dlkj/pi-nano-choc-keyboard/README.md

# pi-nano-choc-keyboard
Split ergo keyboard based on the Rasberry Pi Nano and Kailh Choc v1 switches
