dlkj/pi-nano-choc-keyboard/pcb/pcb_edge.dxf

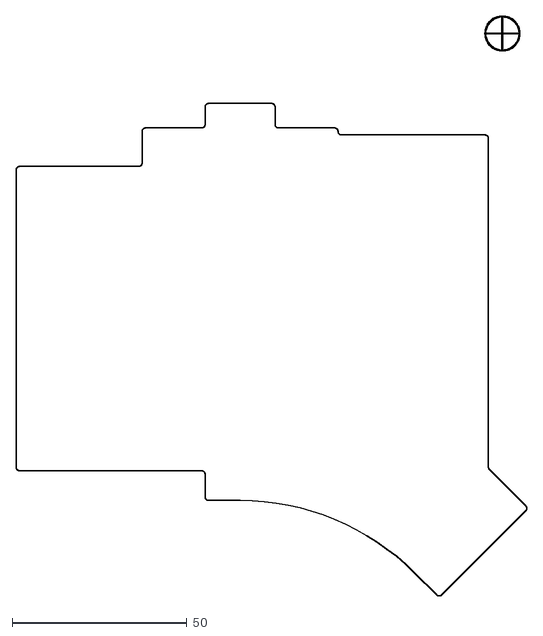
[picture p1: CAD file, 2021-12-23]
pcb/pcb_edge.dxf
146.0 x 165.8
