dlkj/pi-nano-choc-keyboard/pcb/pcb_layout.dxf

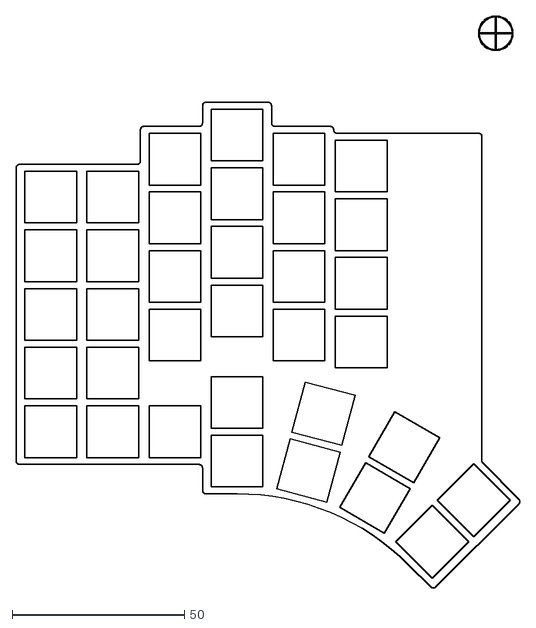
[picture p2: CAD file, 2021-12-23]
pcb/pcb_layout.dxf
146.0 x 165.8
