dlkj/pi-nano-choc-keyboard/(threads)

Thread 1 (2021-12-30):

Broken SPI/OLED display layout on pcb

dlkj, 2021-12-30:
OLED pads were rotated by 180. Need to build a custom footprint with display outline shown.

SDA and SCL were also flipped incorrectly on both sides.
