dlkj/pi-nano-choc-keyboard/pcb/pinanochoc-keyboard/pinanochoc-keyboard.kicad_pcb

## KiCad design pcb/pinanochoc-keyboard/pinanochoc-keyboard.kicad_pcb (2021-12-23)

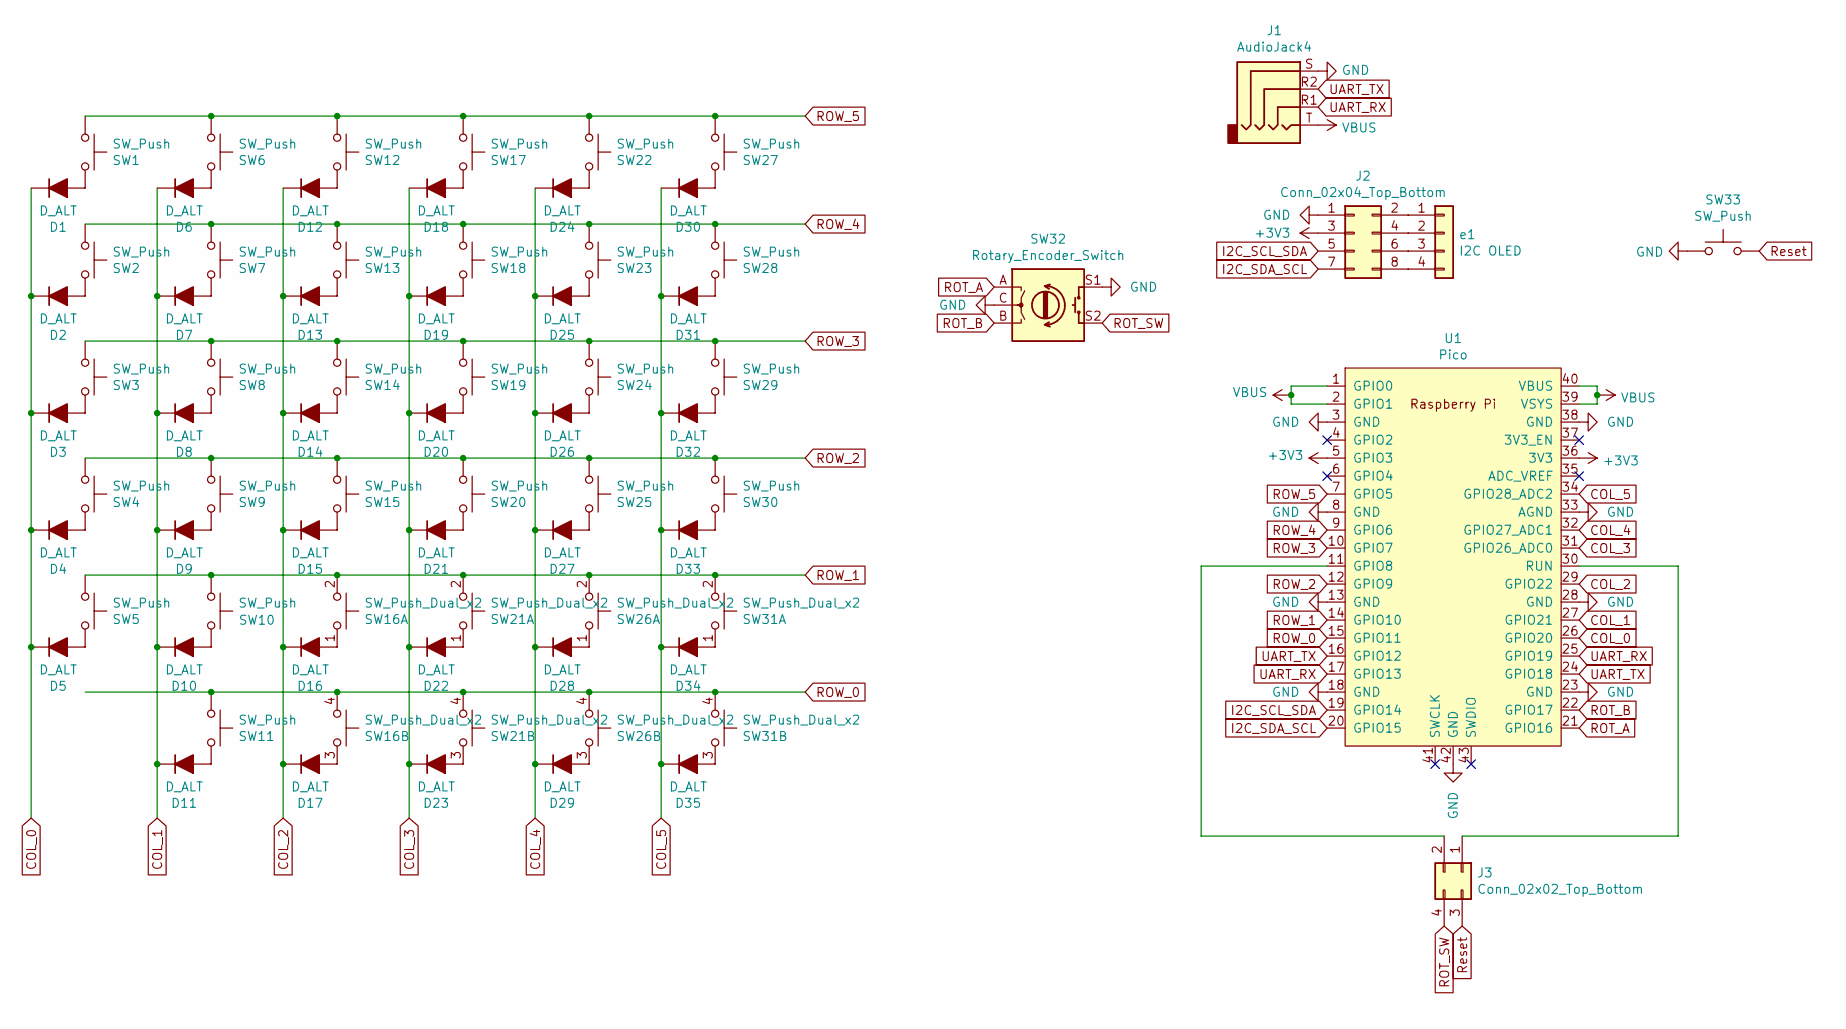
[picture p3: schematic pinanochoc-keyboard.sch]

Parts:
D1, D2, D3, D4, D5, D6, D7, D8, D9, D10, D11, D12, D13, D14, D15, D16, D17, D18, D19, D20, D21, D22, D23, D24, D25, D26, D27, D28, D29, D30, D31, D32, D33, D34, D35: D_ALT; D_DO-35_SOD27_P7.62mm_Horizontal
J1: AudioJack4; TRRS-PJ-320A_reversable
J2: Conn_02x04_Top_Bottom; PinHeader_2x04_P2.54mm_Vertical
J3: Conn_02x02_Top_Bottom; PinHeader_2x02_P2.54mm_Vertical
SW1, SW2, SW3, SW4, SW5, SW6, SW7, SW8, SW9, SW10, SW11, SW12, SW13, SW14, SW15, SW17, SW18, SW19, SW20, SW22, SW23, SW24, SW25, SW27, SW28, SW29, SW30: SW_Push; SW_PG1350_reversible
SW16, SW21, SW26, SW31: SW_Push_Dual_x2; SW_PG1350_reversible_double_rotatable
SW32: Rotary_Encoder_Switch; RotaryEncoder_Alps_EC11E-Switch_Vertical_H20mm
SW33: SW_Push; SW_PUSH_6mm
U1: Pico; RPi_Pico_SMD_TH_flipable
e1: I2C OLED; PinHeader_1x04_P2.54mm_Vertical

Connections:
+3V3: J2.3, U1.5 (GPIO3), U1.36 (3V3)
COL_0: D1.1 (K), D2.1 (K), D3.1 (K), D4.1 (K), D5.1 (K), U1.26 (GPIO20)
COL_1: D6.1 (K), D7.1 (K), D8.1 (K), D9.1 (K), D10.1 (K), D11.1 (K), U1.27 (GPIO21)
COL_2: D12.1 (K), D13.1 (K), D14.1 (K), D15.1 (K), D16.1 (K), D17.1 (K), U1.29 (GPIO22)
COL_3: D18.1 (K), D19.1 (K), D20.1 (K), D21.1 (K), D22.1 (K), D23.1 (K), U1.31 (GPIO26_ADC0)
COL_4: D24.1 (K), D25.1 (K), D26.1 (K), D27.1 (K), D28.1 (K), D29.1 (K), U1.32 (GPIO27_ADC1)
COL_5: D30.1 (K), D31.1 (K), D32.1 (K), D33.1 (K), D34.1 (K), D35.1 (K), U1.34 (GPIO28_ADC2)
GND: J1.S, J2.1, SW32.C, SW32.S1, SW33.1, U1.3 (GND), U1.8 (GND), U1.13 (GND), U1.18 (GND), U1.23 (GND), U1.28 (GND), U1.33 (AGND), U1.38 (GND), U1.42 (GND)
I2C_SCL_SDA: J2.5, U1.19 (GPIO14)
I2C_SDA_SCL: J2.7, U1.20 (GPIO15)
unnamed: D1.2 (A), SW1.1
unnamed: D2.2 (A), SW2.1
unnamed: D3.2 (A), SW3.1
unnamed: D4.2 (A), SW4.1
unnamed: D5.2 (A), SW5.1
unnamed: D6.2 (A), SW6.1
unnamed: D7.2 (A), SW7.1
unnamed: D8.2 (A), SW8.1
unnamed: D9.2 (A), SW9.1
unnamed: D10.2 (A), SW10.1
unnamed: D11.2 (A), SW11.1
unnamed: D12.2 (A), SW12.1
unnamed: D13.2 (A), SW13.1
unnamed: D14.2 (A), SW14.1
unnamed: D15.2 (A), SW15.1
unnamed: D16.2 (A), SW16.1 (C)
unnamed: D17.2 (A), SW16.3 (C)
unnamed: D18.2 (A), SW17.1
unnamed: D19.2 (A), SW18.1
unnamed: D20.2 (A), SW19.1
unnamed: D21.2 (A), SW20.1
unnamed: D22.2 (A), SW21.1 (C)
unnamed: D23.2 (A), SW21.3 (C)
unnamed: D24.2 (A), SW22.1
unnamed: D25.2 (A), SW23.1
unnamed: D26.2 (A), SW24.1
unnamed: D27.2 (A), SW25.1
unnamed: D28.2 (A), SW26.1 (C)
unnamed: D29.2 (A), SW26.3 (C)
unnamed: D30.2 (A), SW27.1
unnamed: D31.2 (A), SW28.1
unnamed: D32.2 (A), SW29.1
unnamed: D33.2 (A), SW30.1
unnamed: D34.2 (A), SW31.1 (C)
unnamed: D35.2 (A), SW31.3 (C)
unnamed: J2.2, e1.1
unnamed: J2.4, e1.2
unnamed: J2.6, e1.3
unnamed: J2.8, e1.4
unnamed: J3.1, U1.30 (RUN)
unnamed: J3.2, U1.11 (GPIO8)
ROT_A: SW32.A, U1.21 (GPIO16)
ROT_B: SW32.B, U1.22 (GPIO17)
ROT_SW: J3.4, SW32.S2
ROW_0: SW11.2, SW16.4 (D), SW21.4 (D), SW26.4 (D), SW31.4 (D), U1.15 (GPIO11)
ROW_1: SW5.2, SW10.2, SW16.2 (D), SW21.2 (D), SW26.2 (D), SW31.2 (D), U1.14 (GPIO10)
ROW_2: SW4.2, SW9.2, SW15.2, SW20.2, SW25.2, SW30.2, U1.12 (GPIO9)
ROW_3: SW3.2, SW8.2, SW14.2, SW19.2, SW24.2, SW29.2, U1.10 (GPIO7)
ROW_4: SW2.2, SW7.2, SW13.2, SW18.2, SW23.2, SW28.2, U1.9 (GPIO6)
ROW_5: SW1.2, SW6.2, SW12.2, SW17.2, SW22.2, SW27.2, U1.7 (GPIO5)
Reset: J3.3, SW33.2
UART_RX: J1.R1, U1.17 (GPIO13), U1.25 (GPIO19)
UART_TX: J1.R2, U1.16 (GPIO12), U1.24 (GPIO18)
VBUS: J1.T, U1.1 (GPIO0), U1.2 (GPIO1), U1.39 (VSYS), U1.40 (VBUS)

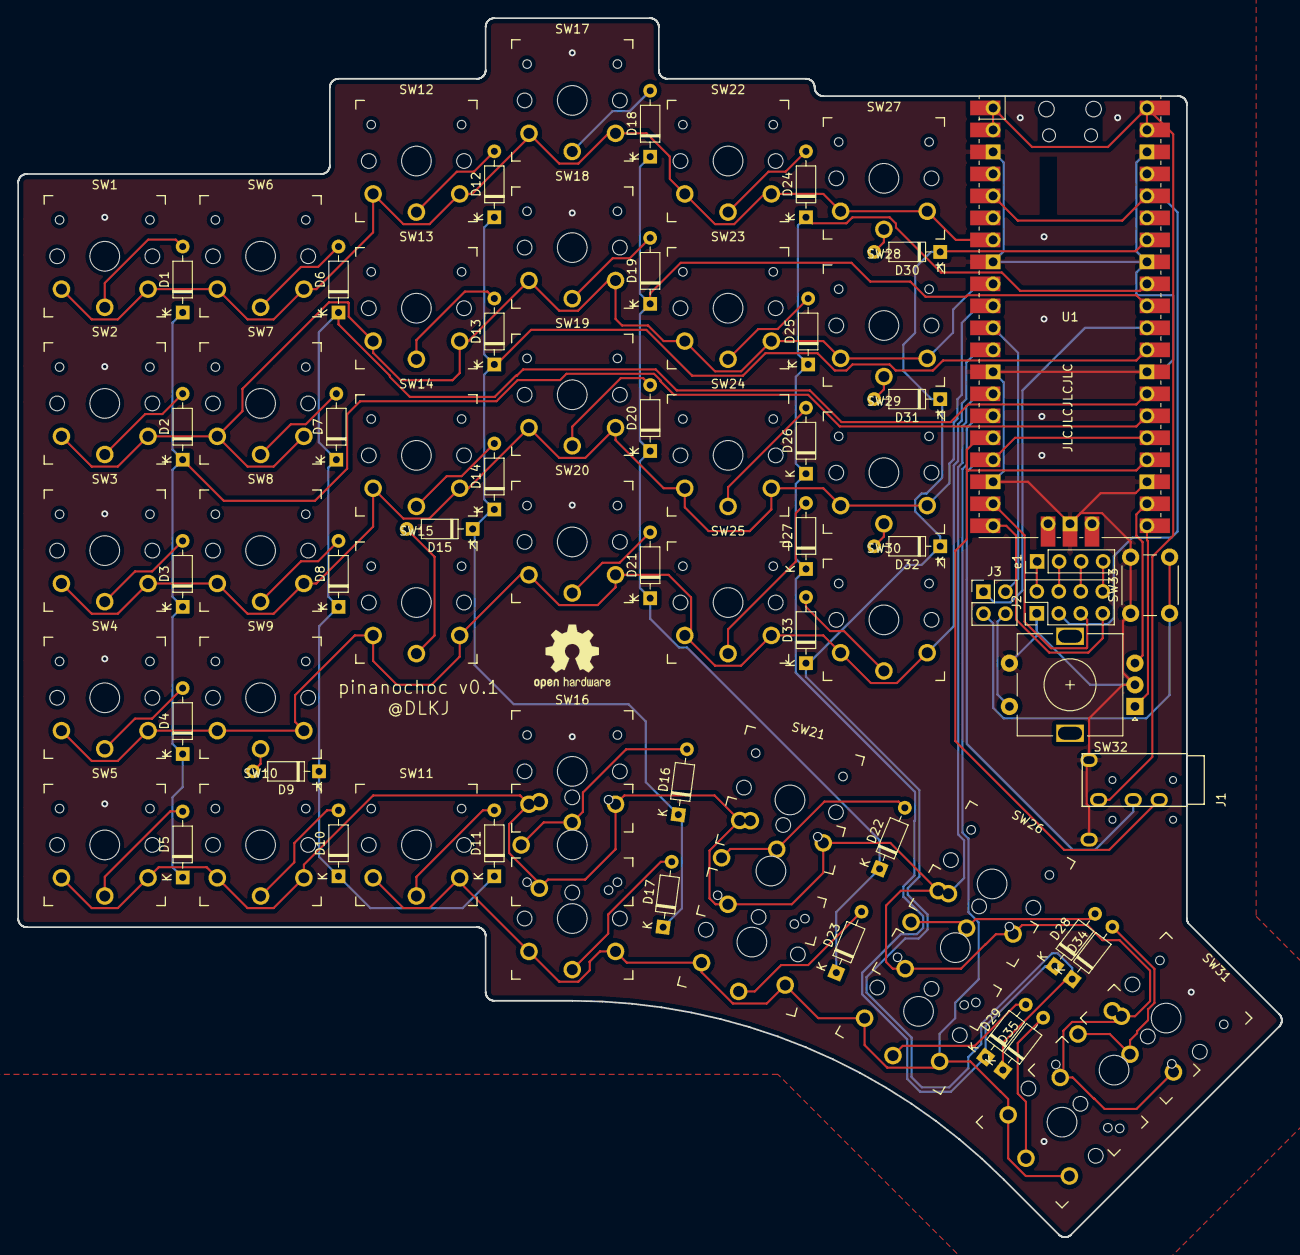
[picture p4: board pinanochoc-keyboard.kicad_pcb from above]

Board: 2 copper layers, 146.0 x 140.8 mm, 73 parts (0 on the bottom side), 64 nets.
