dlkj/pi-nano-choc-keyboard/(commit log)

2021-12-21 WIP left hand pcb
    [pinanococ-keyboard-stagger.kicad_pcb, pinanococ-keyboard.kicad_pcb, pinanococ-keyboard.sch]
2021-12-22 first version of keyboard physical layout in cad
    [pcb_cut.scad]
2021-12-22 pcb component layout
    [pcb_cut.scad, pinanococ-keyboard.kicad_pcb, pinanococ-keyboard.sch]
2021-12-22 inital pcb layout with tracks
    [pinanococ-keyboard.kicad_pcb, pinanococ-keyboard.sch]
2021-12-23 add pcb layout and edge renders
    [pcb_edge.dxf, pcb_layout.dxf]
2021-12-23 reannotated flippable schematic
    [pinanococ-keyboard.sch]
2021-12-23 first draft flipable footprints with scematic
    [pinanococ-keyboard.sch]
2021-12-23 inital switch pcb layout
    [pinanococ-keyboard-stagger.kicad_pcb, pinanococ-keyboard.kicad_pcb, pinanococ-keyboard.sch]
2021-12-23 first pass tracks for pcb
    [pinanococ-keyboard.kicad_pcb]
2021-12-23 v0.1 pcb layout
    [pinanococ-keyboard.kicad_pcb]
2021-12-23 gerbers for v0.1
    [pinanococ-keyboard-B_Cu.gbl, pinanococ-keyboard-B_Mask.gbs, pinanococ-keyboard-B_Paste.gbp, pinanococ-keyboard-B_SilkS.gbo, pinanococ-keyboard-Edge_Cuts.gm1, pinanococ-keyboard-F_Cu.gtl, pinanococ-keyboard-F_Mask.gts, pinanococ-keyboard-F_Paste.gtp]
2021-12-23 rename pinanococ to pinanochoc and fix typo on silk
    [pinanochoc-keyboard-B_Cu.gbl, pinanochoc-keyboard-B_Mask.gbs, pinanochoc-keyboard-B_Paste.gbp, pinanochoc-keyboard-B_SilkS.gbo, pinanochoc-keyboard-Edge_Cuts.gm1, pinanochoc-keyboard-F_Cu.gtl, pinanochoc-keyboard-F_Mask.gts, pinanochoc-keyboard-F_Paste.gtp]
2022-01-02 very basic UART functionality
2022-01-04 fix slice size panic
    [mod.rs]
2022-01-04 add keyboard leds to screen
2022-01-04 remove uart example code comment
2022-01-13 moved to usbd-hid-devices
2022-01-13 swap upper and lower keymaps
    [left.rs]
2022-01-13 added missing usb interupt handler
    [left.rs]
2022-01-13 switch away from interupts while it breaks boot suport
2022-01-13 fix leds and uart init panic
    [left.rs, mod.rs]
2022-01-15 Fix broken key reporting and usb status
    [left.rs, mod.rs]
2022-01-16 Fix and refine panic persist and usb boot on panic
    [left.rs, lib.rs, right.rs]
2022-02-26 updated to latest usb-hid-devices lib
2022-02-26 Added basic rot encoder support to left
2022-03-03 moved left input sampling on to timer irq
2022-03-06 changed clock to u64 to avoid wrapping issue
    [lib.rs]
2022-03-14 Update rp-pico requirement from 0.2 to 0.3 in /firmware
    Updates the requirements on [rp-pico](https://github.com/rp-rs/rp-hal) to permit the latest version.
    - [Release notes](https://github.com/rp-rs/rp-hal/releases)
    - [Commits](https://github.com/rp-rs/rp-hal/compare/rp-pico-0.2.0...rp-pico-v0.3.0)
    ---
    updated-dependencies:
    - dependency-name: rp-pico
    dependency-type: direct:production
    ...
2022-04-02 Upgrade to usbd-human-interface-device
2022-04-06 basic right rotary encoder support
2022-04-06 update uart usage for hal 0.3
2022-05-16 Update usbd-human-interface-device requirement in /firmware
    Updates the requirements on [usbd-human-interface-device](https://github.com/dlkj/usbd-human-interface-device) to permit the latest version.
    - [Release notes](https://github.com/dlkj/usbd-human-interface-device/releases)
    - [Commits](https://github.com/dlkj/usbd-human-interface-device/compare/v0.1.1...v0.2.0)
    - dependency-name: usbd-human-interface-device
    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
2022-05-21 Increase debouncing, fix display update timing, dim screen for screensaver
    [left.rs, lib.rs, mod.rs, oled_display.rs, right.rs]
2022-06-14 Update rp-pico requirement from 0.3 to 0.4 in /firmware
    - [Commits](https://github.com/rp-rs/rp-hal/compare/rp-pico-v0.3.0...v0.4.0)
    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
